Team-Los-Cedros/WRO-RM-2026/tests_resolucion/capturas_fov/fov_800x600.jpg

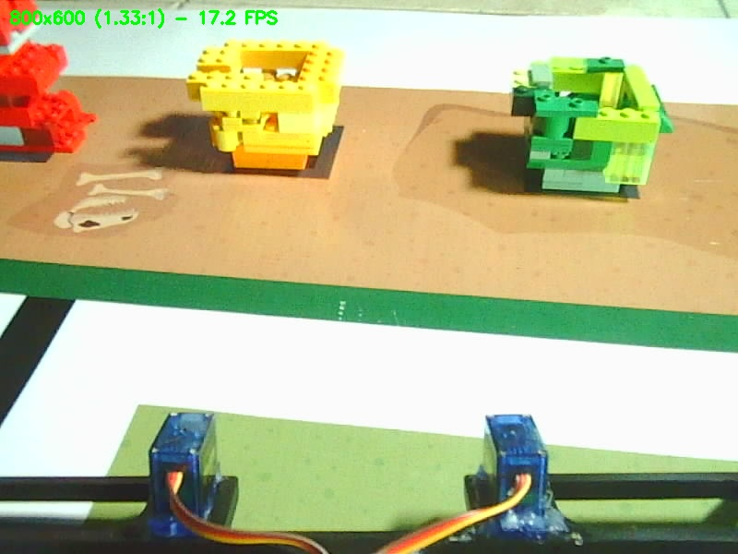
tests_resolucion/capturas_fov/fov_800x600.jpg
