Team-Los-Cedros/WRO-RM-2026/imagenes_robot/20260910_180815.jpg

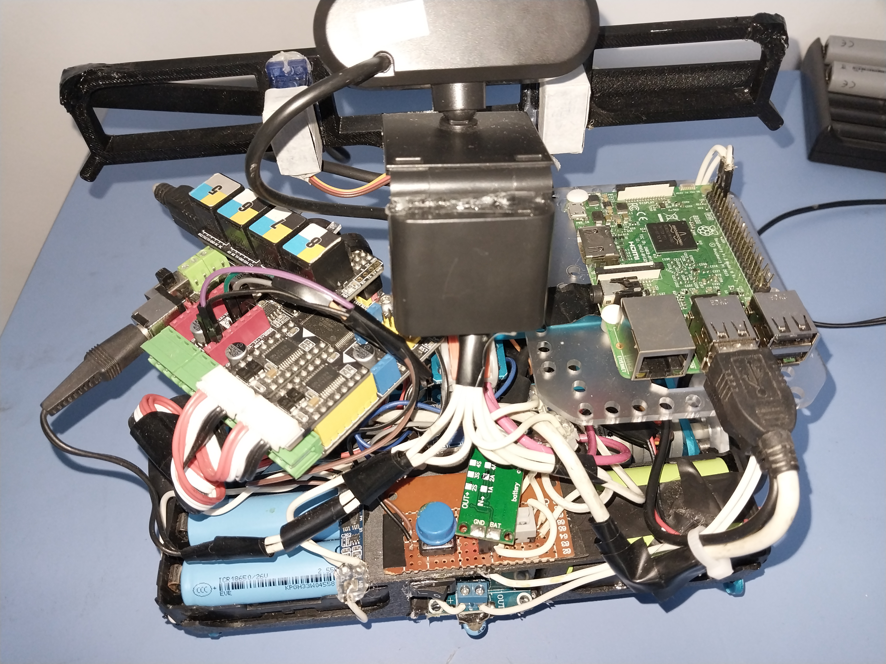
imagenes_robot/20260910_180815.jpg
