Team-Los-Cedros/WRO-RM-2026/robot_WRO/ruta_visitantes/calibrar_gyro/calibrar_gyro.ino

// ============================================================================
//  calibrar_gyro.ino  -  Herramienta de calibracion para prueba_wwl5_opt.ino
//
//  Sirve para sacar los cuatro numeros que hacen falta en el sketch principal:
//     GYRO_ESCALA    factor de correccion del giroscopio
//     RPM_MAX        rpm del eje de salida con PWM 255
//     GIRO_PWM_MIN   PWM minimo que hace girar al robot
//     RECTO_PWM_MIN  PWM minimo que hace avanzar al robot
//  y ademas comprueba la salud del bus I2C (errores y tiempo de lectura).
//
//  USO: sube el sketch, abre el Monitor Serie a 115200 con final de linea
//       "Nueva linea" o "Sin ajuste de linea", y escribe una letra:
//
//     s  Salud del bus I2C: errores y microsegundos por lectura
//     b  Sesgo y ruido del giroscopio (deja el robot QUIETO)
//     a  Escala del giroscopio AUTOMATICA: el robot da 3 vueltas solo
//     e  Escala del giroscopio a mano (poco fiable, ver nota abajo)
//     v  Velocidad maxima de los motores (rpm a PWM 255)
//     m  PWM minimo de arranque (giro y recto)
//     t  Prueba de repetibilidad: 5 giros de 90 grados
//     ?  Vuelve a mostrar este menu
//
//  NOTA sobre la escala: NO la midas girando el robot a mano. El giroscopio
//  integra rotacion sobre SU eje Z, no rumbo sobre el suelo. En cuanto lo
//  levantas o lo inclinas, lo que mide deja de tener relacion con los grados
//  que gira sobre la pista, y salen resultados que se contradicen entre si.
//  Usa la opcion 'a': el robot gira solo, apoyado, y tu solo mides el error
//  final con un transportador.
// ============================================================================

#include <Arduino.h>
#include <Wire.h>
#include <MeMegaPi.h>

#define I2C_HZ          400000UL
#define I2C_TIMEOUT_US    4000UL
#define MPU_ADDR            0x68
#define PWM_TOPE             255

MeEncoderOnBoard Encoder_1(SLOT1);
MeEncoderOnBoard Encoder_2(SLOT2);

// ---------------------------------------------------------------- giroscopio
float    gBias = 0.0f, gH = 0.0f, gW = 0.0f, gWprev = 0.0f;
uint32_t gTUlt = 0, gTMuestra = 0;
uint16_t gErr = 0;
uint32_t gLecturas = 0, gMicrosTotal = 0;

bool gyroEscribir(uint8_t reg, uint8_t valor)
{
  Wire.beginTransmission(MPU_ADDR);
  Wire.write(reg);
  Wire.write(valor);
  return (Wire.endTransmission(true) == 0);
}

bool gyroLeerZ(int16_t &destino)
{
  uint32_t t0 = micros();
  Wire.beginTransmission(MPU_ADDR);
  Wire.write((uint8_t)0x47);
  if (Wire.endTransmission(false) != 0) { Wire.clearWireTimeoutFlag(); gErr++; return false; }
  if (Wire.requestFrom((uint8_t)MPU_ADDR, (uint8_t)2, (uint8_t)true) != 2) {
    Wire.clearWireTimeoutFlag(); gErr++; return false;
  }
  uint8_t alto = Wire.read();
  uint8_t bajo = Wire.read();
  destino = (int16_t)(((uint16_t)alto << 8) | bajo);
  gMicrosTotal += (micros() - t0);
  gLecturas++;
  return true;
}

bool gyroBegin(void)
{
  Wire.begin();
  Wire.setClock(I2C_HZ);
  Wire.setWireTimeout(I2C_TIMEOUT_US, true);

  gyroEscribir(0x6B, 0x80);
  delay(120);
  Wire.setClock(I2C_HZ);
  if (!gyroEscribir(0x6B, 0x01)) return false;
  delay(20);
  gyroEscribir(0x1A, 0x02);
  gyroEscribir(0x19, 0x00);
  gyroEscribir(0x1B, 0x08);
  delay(20);

  int16_t v;
  bool ok = gyroLeerZ(v);
  gTUlt = gTMuestra = micros();
  return ok;
}

void gyroCalibrar(uint16_t muestras)
{
  long suma = 0;
  uint16_t buenas = 0;
  for (uint16_t i = 0; i < muestras; i++) {
    int16_t v;
    if (gyroLeerZ(v)) { suma += v; buenas++; }
    delay(2);
  }
  if (buenas) gBias = (float)suma / (float)buenas;
  gH = gW = gWprev = 0.0f;
  gTUlt = gTMuestra = micros();
}

void gyroUpdate(void)
{
  uint32_t ahora = micros();
  if (ahora - gTMuestra < 2000UL) return;
  gTMuestra = ahora;

  int16_t crudo;
  if (!gyroLeerZ(crudo)) return;

  float dt = (float)(ahora - gTUlt) * 1.0e-6f;
  gTUlt = ahora;
  if (dt > 0.05f) dt = 0.05f;

  gWprev = gW;
  gW = ((float)crudo - gBias) / 65.5f;
  gH += 0.5f * (gW + gWprev) * dt;
}

// ------------------------------------------------------------------- motores
void isr_encoder1(void) { if (PINC & _BV(PC6)) Encoder_1.pulsePosPlus(); else Encoder_1.pulsePosMinus(); }
void isr_encoder2(void) { if (PIND & _BV(PD7)) Encoder_2.pulsePosPlus(); else Encoder_2.pulsePosMinus(); }

void modoDirecto(void)
{
  Encoder_1.setMotionMode(DIRECT_MODE);
  Encoder_2.setMotionMode(DIRECT_MODE);
}
// Compensacion del motor izquierdo, igual que en el sketch principal.
// Solo se aplica al giro: la prueba 'v' tiene que medir los motores tal cual.
#define TRIM_MOTOR_IZQ 0.938f

void pwmGiro(int16_t p)
{
  p = constrain(p, -PWM_TOPE, PWM_TOPE);
  Encoder_1.setMotorPwm((int16_t)((float)p * TRIM_MOTOR_IZQ));
  Encoder_2.setMotorPwm(p);
}
void pwmRuedas(int16_t izq, int16_t der)
{
  Encoder_1.setMotorPwm(constrain(izq, -PWM_TOPE, PWM_TOPE));
  Encoder_2.setMotorPwm(constrain(-der, -PWM_TOPE, PWM_TOPE));
}
void frenar(void) { modoDirecto(); Encoder_1.setMotorPwm(0); Encoder_2.setMotorPwm(0); }

void tarea(void)
{
  gyroUpdate();
  static uint32_t tEnc = 0;
  uint32_t ahora = micros();
  if (ahora - tEnc >= 10000UL) { tEnc = ahora; Encoder_1.loop(); Encoder_2.loop(); }
}

void esperar(uint32_t ms)
{
  uint32_t t = millis();
  while (millis() - t < ms) tarea();
}

// Espera a que el usuario pulse ENTER. Limpia el buffer ANTES y DESPUES, con
// una pausa: si el monitor manda CR+LF, el segundo byte llega unos microsegundos
// mas tarde y sin la pausa dispararia la siguiente espera al instante.
void esperarEnter(void)
{
  while (Serial.available()) Serial.read();
  while (!Serial.available()) tarea();
  esperar(80);
  while (Serial.available()) Serial.read();
}

// Frena, espera a que el robot quede REALMENTE quieto y devuelve.
void asentar(uint16_t msMax)
{
  frenar();
  uint32_t ini = millis(), desde = millis();
  while (millis() - ini < msMax) {
    tarea();
    if (fabs(gW) > 4.0f) desde = millis();
    else if (millis() - desde >= 60) return;
  }
}

// Giro con la MISMA logica que el sketch principal: rampa de frenado,
// asentamiento y correccion del error medido.
void giroCerrado(float objetivo, int16_t pwmCrucero, uint16_t msMax)
{
  float    h0    = gH;
  uint32_t tIni  = millis();
  modoDirecto();

  while (millis() - tIni < msMax) {
    tarea();
    float falta = objetivo - fabs(gH - h0);
    if (falta <= 0.0f) break;
    int16_t p = (int16_t)(40.0f * sqrt(falta));
    p = constrain(p, (int16_t)39, pwmCrucero);
    pwmGiro(p);
    delay(5);
  }
  asentar(350);

  for (uint8_t n = 0; n < 3; n++) {
    float err = objetivo - fabs(gH - h0);
    if (fabs(err) <= 0.8f) break;
    int8_t dir = (err > 0.0f) ? 1 : -1;
    uint32_t tC = millis(), tMov = millis();
    while (millis() - tC < 700UL) {
      tarea();
      float e = objetivo - fabs(gH - h0);
      if ((err > 0.0f && e <= 0.0f) || (err < 0.0f && e >= 0.0f)) break;
      if (fabs(gW) > 8.0f) tMov = millis();
      uint32_t parado = millis() - tMov;
      int16_t p = 39 + (parado > 120 ? (int16_t)((parado - 120) / 12) : 0);
      if (p > 120) p = 120;
      pwmGiro((int16_t)(p * dir));
      delay(5);
    }
    asentar(350);
  }
}

// ============================================================================
//  PRUEBAS
// ============================================================================

void pruebaSalud(void)
{
  Serial.println(F("\n--- Salud del bus I2C (5 s) ---"));
  gErr = 0; gLecturas = 0; gMicrosTotal = 0;
  uint32_t t = millis();
  while (millis() - t < 5000UL) gyroUpdate();

  Serial.print(F("Lecturas correctas : ")); Serial.println(gLecturas);
  Serial.print(F("Errores            : ")); Serial.println(gErr);
  Serial.print(F("Microsegundos/lect : "));
  Serial.println(gLecturas ? (gMicrosTotal / gLecturas) : 0);
  if (gErr == 0) Serial.println(F("OK: el bus va fino a 400 kHz."));
  else           Serial.println(F("AVISO: baja I2C_HZ a 200000 y revisa el cable RJ25."));
}

void pruebaSesgo(void)
{
  Serial.println(F("\n--- Sesgo y ruido (deja el robot QUIETO 6 s) ---"));
  esperar(500);

  long suma = 0;
  int16_t minimo = 32767, maximo = -32768;
  uint16_t n = 0;
  uint32_t t = millis();
  while (millis() - t < 3000UL) {
    int16_t v;
    if (gyroLeerZ(v)) { suma += v; if (v < minimo) minimo = v; if (v > maximo) maximo = v; n++; }
    delay(2);
  }
  if (!n) { Serial.println(F("Sin lecturas.")); return; }

  float bias = (float)suma / (float)n;
  Serial.print(F("Sesgo crudo   : ")); Serial.println(bias, 2);
  Serial.print(F("Ruido pico-pico: "));
  Serial.print(((float)maximo - (float)minimo) / 65.5f, 2);
  Serial.println(F(" grados/s"));

  // deriva con ese sesgo aplicado
  gBias = bias;
  gH = 0.0f; gW = 0.0f; gWprev = 0.0f;
  gTUlt = gTMuestra = micros();
  t = millis();
  while (millis() - t < 3000UL) gyroUpdate();
  Serial.print(F("Deriva en 3 s : ")); Serial.print(gH, 3); Serial.println(F(" grados"));
  Serial.print(F("Deriva/minuto : ")); Serial.print(gH * 20.0f, 2); Serial.println(F(" grados"));
}

/**
 * Escala del giroscopio, metodo AUTOMATICO. Es el bueno.
 *
 * El robot da 3 vueltas completas el solo, apoyado en el suelo. Asi el eje Z
 * del sensor se mantiene vertical todo el rato y lo que integra es rumbo de
 * verdad. Girarlo a mano no vale: en cuanto lo inclinas o lo levantas, el
 * integral del eje Z deja de ser el rumbo del suelo y la medida sale
 * cualquier cosa (por eso dos intentos a mano pueden dar 0,77 y 1,49).
 */
void pruebaEscalaAuto(void)
{
  const float OBJETIVO = 1080.0f;   // 3 vueltas

  Serial.println(F("\n--- Escala del giroscopio (AUTOMATICO) ---"));
  Serial.println(F("1. Pon el robot EN EL SUELO, en la pista."));
  Serial.println(F("2. Marca con cinta por donde apunta exactamente"));
  Serial.println(F("   (pega una tira que sobresalga por delante y marca el suelo)."));
  Serial.println(F("3. Pulsa ENTER y NO lo toques. Dara 3 vueltas."));
  esperarEnter();

  Serial.print(F("Calibrando sesgo... "));
  gyroCalibrar(300);
  Serial.println(F("girando."));

  giroCerrado(OBJETIVO, 130, 25000UL);

  float medido = fabs(gH);
  Serial.print(F("El robot creyo girar: ")); Serial.print(medido, 2); Serial.println(F(" grados"));
  Serial.println(F("Mide ahora cuanto se desvio de la marca:"));
  Serial.println(F("  POSITIVO si se paso, NEGATIVO si le falto."));
  Serial.println(F("Escribe el error en grados y pulsa ENTER (ej: 12  o  -8):"));

  while (Serial.available()) Serial.read();
  while (!Serial.available()) tarea();
  float err = Serial.parseFloat();
  esperar(80);
  while (Serial.available()) Serial.read();

  float escala = (OBJETIVO + err) / OBJETIVO;
  Serial.print(F("\n>>> GYRO_ESCALA = ")); Serial.println(escala, 4);
  if (fabs(escala - 1.0f) < 0.01f)
    Serial.println(F("    (menos de un 1 % de error: dejalo en 1.000)"));
  else if (fabs(escala - 1.0f) > 0.15f)
    Serial.println(F("    OJO: mas de un 15 %. Repite la medida, algo salio mal."));
}

/**
 * Escala del giroscopio, metodo MANUAL. Solo sirve si el robot se queda
 * perfectamente plano sobre el suelo mientras lo giras, y si lo giras en menos
 * de ~15 segundos. Usa mejor la opcion 'a'.
 */
void pruebaEscala(void)
{
  Serial.println(F("\n--- Escala del giroscopio (manual) ---"));
  Serial.println(F("AVISO: este metodo solo vale si DESLIZAS el robot sobre el"));
  Serial.println(F("suelo sin levantarlo ni inclinarlo, y sin tardar mucho."));
  Serial.println(F("Si puedes, usa la opcion 'a' en su lugar."));
  Serial.print  (F("Calibrando sesgo... "));
  gyroCalibrar(300);
  Serial.println(F("listo. Pulsa ENTER para empezar."));
  esperarEnter();

  gH = 0.0f; gW = 0.0f; gWprev = 0.0f;
  gTUlt = gTMuestra = micros();
  uint32_t tIni = millis();
  Serial.println(F("GIRANDO... pulsa ENTER al terminar."));
  esperarEnter();

  uint32_t seg = (millis() - tIni) / 1000UL;
  Serial.print(F("El giroscopio midio: ")); Serial.print(gH, 2);
  Serial.print(F(" grados en ")); Serial.print(seg); Serial.println(F(" s"));
  if (seg > 20) Serial.println(F("AVISO: has tardado demasiado. La medida no es fiable."));
  if (fabs(gH) > 30.0f) {
    Serial.print(F("Si giraste 360  -> GYRO_ESCALA = ")); Serial.println(360.0f  / fabs(gH), 4);
    Serial.print(F("Si giraste 720  -> GYRO_ESCALA = ")); Serial.println(720.0f  / fabs(gH), 4);
    Serial.print(F("Si giraste 1080 -> GYRO_ESCALA = ")); Serial.println(1080.0f / fabs(gH), 4);
  }
}

void pruebaVelocidad(void)
{
  Serial.println(F("\n--- Velocidad maxima (levanta las ruedas del suelo) ---"));
  Serial.println(F("Arranca en 3 s..."));
  esperar(3000);

  modoDirecto();
  pwmRuedas(255, 255);
  esperar(2500);                    // dejar que se estabilice

  float sumaIzq = 0, sumaDer = 0;
  uint16_t n = 0;
  uint32_t t = millis();
  while (millis() - t < 1500UL) {
    tarea();
    sumaIzq += fabs(Encoder_1.getCurrentSpeed());
    sumaDer += fabs(Encoder_2.getCurrentSpeed());
    n++;
    delay(10);
  }
  frenar();

  float vIzq = sumaIzq / n;
  float vDer = sumaDer / n;
  Serial.print(F("Motor izquierdo (SLOT1): ")); Serial.print(vIzq, 1); Serial.println(F(" rpm"));
  Serial.print(F("Motor derecho   (SLOT2): ")); Serial.print(vDer, 1); Serial.println(F(" rpm"));
  Serial.print(F("Pon RPM_MAX = ")); Serial.println(min(vIzq, vDer), 0);
  float dif = fabs(vIzq - vDer) / max(vIzq, vDer) * 100.0f;
  Serial.print(F("Diferencia entre motores: ")); Serial.print(dif, 1); Serial.println(F(" %"));
  if (dif > 8.0f) Serial.println(F("AVISO: mas de un 8 % de diferencia. Revisa mecanica o driver."));
}

void pruebaPwmMinimo(void)
{
  Serial.println(F("\n--- PWM minimo de arranque (robot EN EL SUELO) ---"));
  esperar(1500);

  // giro
  gyroCalibrar(200);
  modoDirecto();
  int16_t pGiro = 0;
  for (int16_t p = 15; p <= 120; p += 2) {
    pwmGiro(p);
    uint32_t t = millis();
    float pico = 0;
    while (millis() - t < 260UL) { tarea(); if (fabs(gW) > pico) pico = fabs(gW); }
    if (pico > 20.0f) { pGiro = p; break; }
  }
  frenar();
  esperar(600);

  // recto
  long p0i = Encoder_1.getPulsePos();
  int16_t pRecto = 0;
  for (int16_t p = 15; p <= 120; p += 2) {
    long antes = Encoder_1.getPulsePos();
    pwmRuedas(p, p);
    esperar(260);
    if (labs(Encoder_1.getPulsePos() - antes) > 25) { pRecto = p; break; }
  }
  frenar();
  (void)p0i;

  Serial.print(F("GIRO_PWM_MIN  sugerido = ")); Serial.println(pGiro  ? pGiro  + 8 : 45);
  Serial.print(F("RECTO_PWM_MIN sugerido = ")); Serial.println(pRecto ? pRecto + 6 : 35);
  Serial.println(F("(se suma un margen para que arranque siempre)"));
}

void pruebaRepetibilidad(void)
{
  Serial.println(F("\n--- 5 giros de 90 grados (robot EN EL SUELO) ---"));
  Serial.println(F("Usa el mismo lazo cerrado que el sketch de competencia:"));
  Serial.println(F("rampa de frenado + asentamiento + correccion del error."));
  Serial.println(F("Marca la posicion inicial. Arranca en 3 s..."));
  esperar(3000);
  gyroCalibrar(250);

  float peor = 0.0f;
  for (uint8_t i = 0; i < 5; i++) {
    float h0 = gH;
    giroCerrado(90.0f, 194, 5000UL);    // 194 = PWM de 120 rpm
    float real = fabs(gH - h0);
    if (fabs(real - 90.0f) > peor) peor = fabs(real - 90.0f);
    Serial.print(F("Giro ")); Serial.print(i + 1);
    Serial.print(F(": ")); Serial.print(real, 2); Serial.println(F(" grados"));
    esperar(600);
  }
  Serial.print(F("Peor error: ")); Serial.print(peor, 2); Serial.println(F(" grados"));
  Serial.print(F("Rumbo acumulado tras 5 giros (deberia ser ~450): "));
  Serial.println(fabs(gH), 2);
  Serial.println(F("Comprueba en el suelo: tras 5 giros de 90 el robot deberia"));
  Serial.println(F("quedar a 90 grados de la marca inicial (450 = una vuelta + 90)."));
  Serial.println(F("Si no es asi, la escala del giroscopio esta mal: usa la opcion 'a'."));
}

void menu(void)
{
  Serial.println(F("\n================ CALIBRACION MEGAPI ================"));
  Serial.println(F(" s  Salud del bus I2C"));
  Serial.println(F(" b  Sesgo y ruido del giroscopio (robot quieto)"));
  Serial.println(F(" a  Escala del giroscopio AUTOMATICA  <-- usa esta"));
  Serial.println(F(" e  Escala del giroscopio a mano (poco fiable)"));
  Serial.println(F(" v  Velocidad maxima (ruedas al aire)"));
  Serial.println(F(" m  PWM minimo de arranque (robot en el suelo)"));
  Serial.println(F(" t  5 giros de 90 grados (robot en el suelo)"));
  Serial.println(F(" ?  Repetir este menu"));
  Serial.println(F("===================================================="));
}

void setup()
{
  Serial.begin(115200);
  while (!Serial) { ; }

  pinMode(4, INPUT_PULLUP);

  TCCR1A = _BV(WGM10);               TCCR1B = _BV(WGM12) | _BV(CS11);
  TCCR2A = _BV(WGM21) | _BV(WGM20);  TCCR2B = _BV(CS21);
  TCCR4A = _BV(WGM40);               TCCR4B = _BV(WGM42) | _BV(CS41);

  attachInterrupt(digitalPinToInterrupt(Encoder_1.getPortA()), isr_encoder1, RISING);
  attachInterrupt(digitalPinToInterrupt(Encoder_2.getPortA()), isr_encoder2, RISING);
  Encoder_1.setPulse(8); Encoder_2.setPulse(8);
  Encoder_1.setRatio(46); Encoder_2.setRatio(46);
  modoDirecto();
  frenar();

  if (!gyroBegin()) Serial.println(F("ERROR: el MPU6050 no responde."));
  gyroCalibrar(250);

  menu();
}

void loop()
{
  tarea();
  if (!Serial.available()) return;

  char c = Serial.read();
  while (Serial.available()) Serial.read();     // vaciar el resto de la linea

  switch (c) {
    case 's': pruebaSalud();          break;
    case 'b': pruebaSesgo();          break;
    case 'a': pruebaEscalaAuto();     break;
    case 'e': pruebaEscala();         break;
    case 'v': pruebaVelocidad();      break;
    case 'm': pruebaPwmMinimo();      break;
    case 't': pruebaRepetibilidad();  break;
    case '?': menu();                 break;
    default:  return;
  }
  Serial.println(F("\nListo. Escribe otra letra (? para el menu)."));
}
