Team-Los-Cedros/WRO-RM-2026/(commit log)

2026-08-01 Anadir vision con Raspberry Pi 3B para localizar y recoger objetos
    La MegaPi sigue siendo el cerebro de la rutina y la Raspberry actua como
    sensor inteligente: detecta por HSV el objeto del color pedido y manda por
    serial el error de posicion para que el robot lo centre en la garra. Asi el
    robot no depende de que la Pi arranque a tiempo, y si la Pi falla la rutina
    por encoders y giroscopio sigue funcionando.
    Lado Raspberry (vision/):
    - Deteccion HSV a 320x240 con ROI recortada y una sola mascara por frame.
    - Camara con hilo lector: CAP_PROP_BUFFERSIZE=1 partia el framerate a la
    mitad (20 -> 10 fps) porque el driver descarta el frame N+1 mientras se
    procesa el N. Con 3 buffers y el hilo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
    [calibrar_web.py, prueba_vision.ino, test_protocolo.py, vision_core.py, vision_server.py]
2026-08-31 Recolección objetos de color con garra
2026-08-31 Interfaz de ajuste de cámara
2026-08-31 Pruebas de resolución de cámara
2026-08-31 Quitar recolección desde el interior
2026-08-31 Integrar vision AUTO y ciclo de cuatro artefactos
2026-08-31 Conservar el color solicitado en modo fijo
2026-08-31 Corregir ruta del servicio de vision en Raspberry
2026-08-31 Actualizar calibracion de camara conectada
2026-08-31 Ampliar formato de video
2026-09-01 Agregar gestor de exclusividad de cámara para evitar conflictos en el uso simultáneo
2026-09-01 Agregar manejo de warnings de libjpeg y optimizar el streaming de JPEGs pre-codificados
2026-09-01 Directivas para el agente de IA y conexión a Raspberry Pi
2026-09-01 Correción de error al compilar
    [prueba_vision.ino]
2026-09-01 Herramientas de grabación para diagnóstico
2026-09-01 Ignorar grabación de sesiones
2026-09-02 Separar modos de vision y recuperar dispositivos USB
2026-09-02 Aclarar modo activo en log de vision
2026-09-02 Estabilizar mapa de slots en bordes de camara
2026-09-04 Implementa mejoras en la navegación y calibración de visión
    - Añade funciones para alinear el rumbo utilizando el giroscopio, mejorando la precisión en la navegación.
    - Modifica la lógica de giro para aprender el signo del giro físico y evitar giros peligrosos.
    - Introduce un nuevo calibrador para los cuadros planos del museo, permitiendo ajustes específicos de color y ROI.
    - Actualiza la configuración de colores y parámetros de detección en `config.json` para mejorar la detección de artefactos.
    - Agrega pruebas unitarias para validar el comportamiento del detector con diferentes condiciones de entrada.
2026-09-04 Carpeta de pruebas de visitantes
2026-09-04 Mejorar giro con giroscopio sin limitación de ángulo
2026-09-04 Depositar dos visitantes en la zona rectagular
2026-09-04 Implementar barrido de objetos con los servos sg90 y recolectar los otros dos objetos
2026-09-04 Usar sensor seguidor de línea para detener el avance recto al llegar a la línea
2026-09-04 Versiones anteriores de rutas de visitantes
2026-09-04 Ajustar odometria entre slots y vision de destino
    - Compensar 140° de retroceso en retorno del museo para situar el robot en cota Y optima
    - Anticipar activacion de DESTINO durante aproximacion al expositor
    - Flexibilizar marco blanco y borde inferior en detectar_destino
    - Ajustar rangos HSV de negro en config.json
2026-09-07 ubicar el negro
2026-09-07 Correciones para ubicar torre
2026-09-07 Ubicar artefactos con los cuadros de los lados
2026-09-07 Copias de versiones
2026-09-10 Copias de códigos
2026-09-11 Ajustar fondo en prueba sintetica de destino para validar calibracion de negro
